KargJonas/nrf24-esp-mesh-network/media/esp8266-12e.png

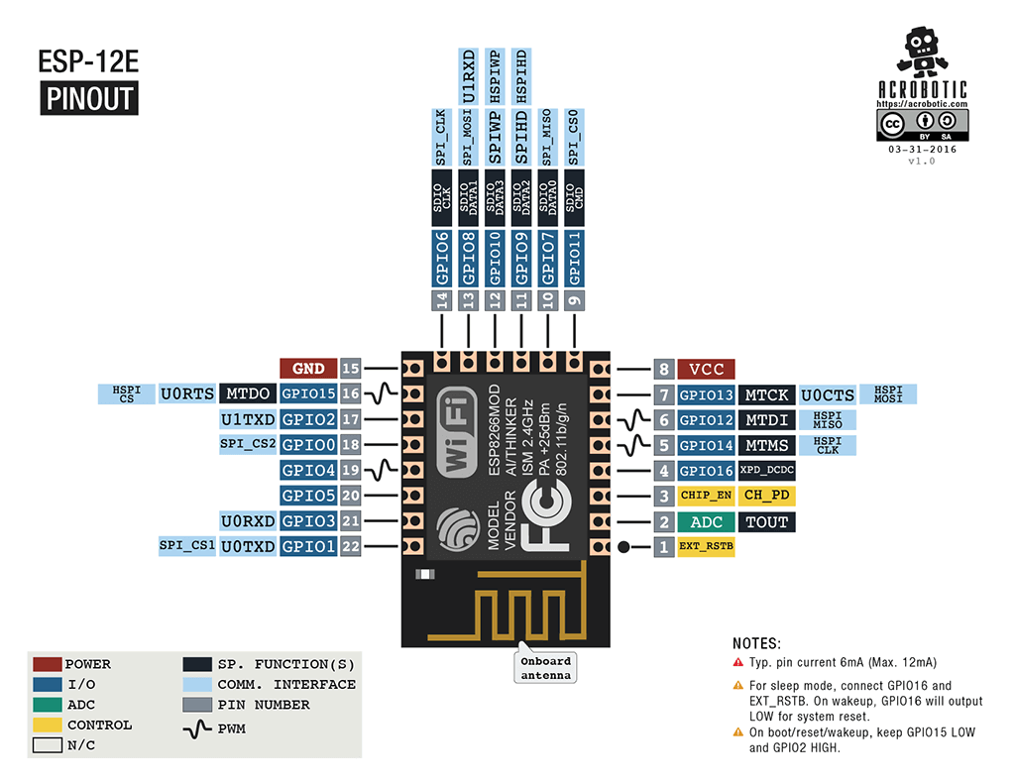
media/esp8266-12e.png
